umass-hrsl/ThermoClock/Acrylic tray design(STL).STL

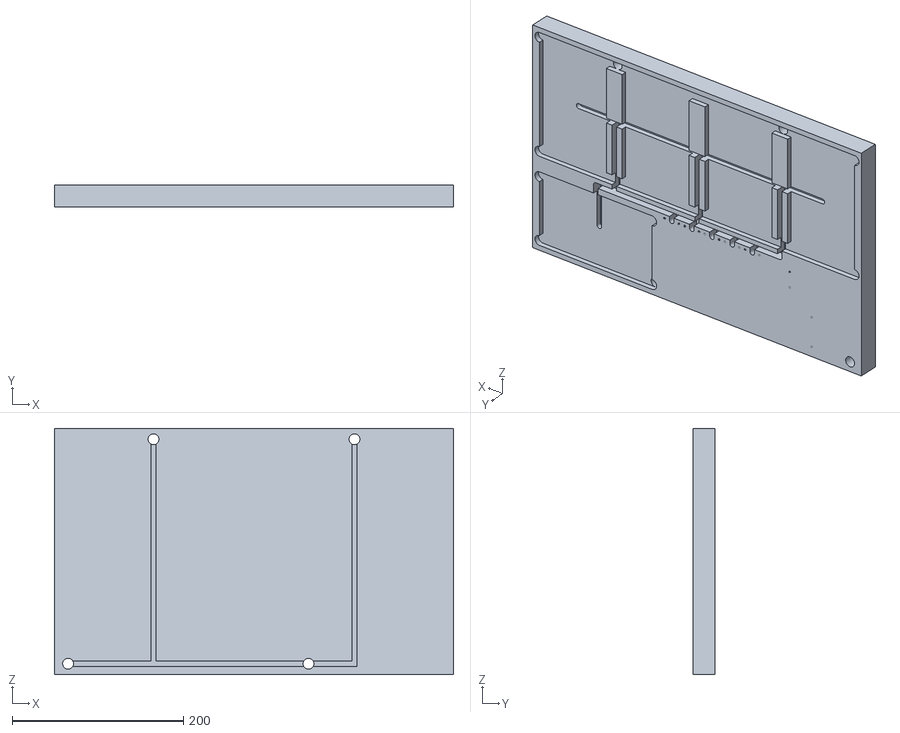
[picture p1: CAD file, 2025-08-20]
Acrylic tray design(STL).STL
466.5 x 25.4 x 287.7
