umass-hrsl/ThermoClock/alternative single module fixture CAD/6 well plate holder v3.SLDPRT

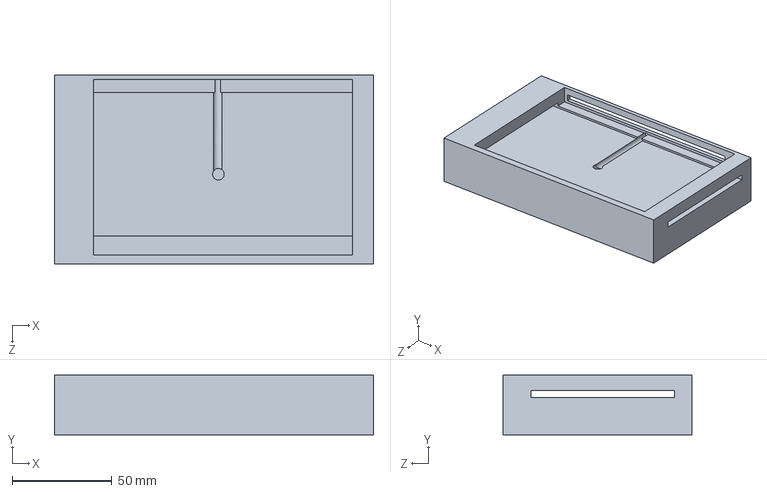
[picture p2: CAD file, 2024-07-17]
alternative single module fixture CAD/6 well plate holder v3.SLDPRT
160.0 x 30.0 x 95.0 mm
