umass-hrsl/ThermoClock/(list of files, cad)

Other CAD files:
alternative single module fixture CAD/6 well plate holder v3.STL
