umass-hrsl/ThermoClock/PCB Design/ThermoClock PCB.kicad_pcb

## KiCad design PCB Design/ThermoClock PCB.kicad_pcb (2025-02-21)

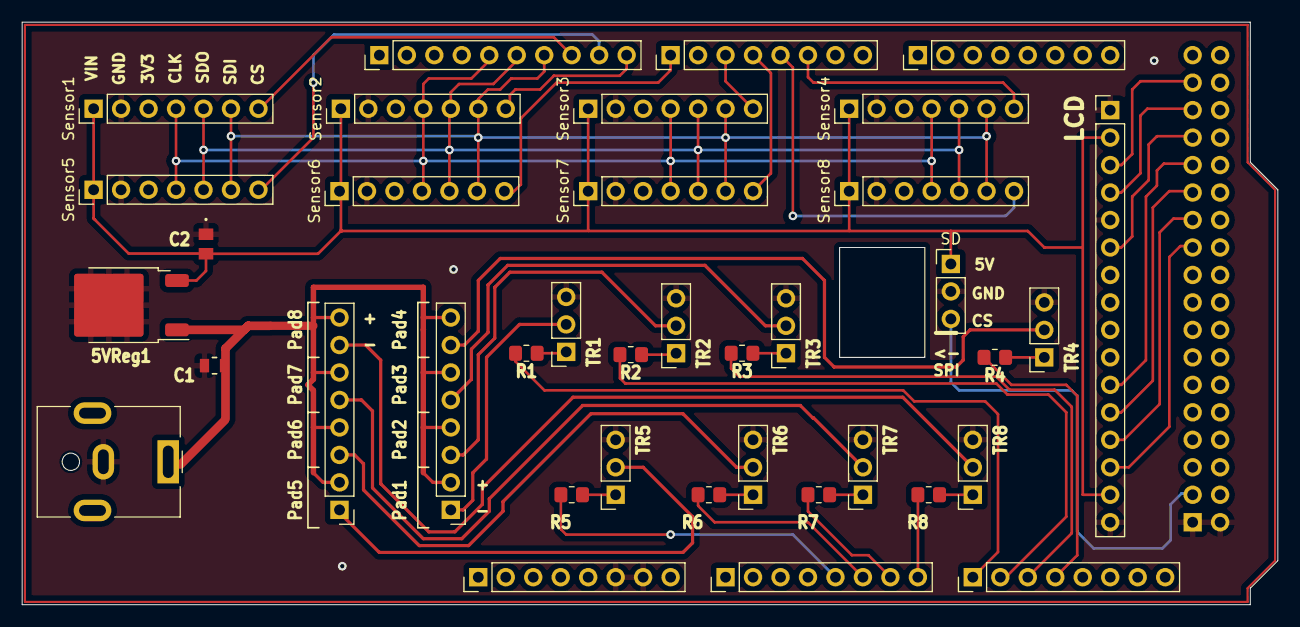
[picture p3: board ThermoClock PCB.kicad_pcb from above]

Board: 2 copper layers, 116.1 x 53.8 mm, 39 parts (1 on the bottom side), 47 nets.

Parts:
5VReg1: LM78M05_TO252; TO-252-2
C1: C; CAP_CL21_SAM
C2: C; CAP_0805_B_WAL
J1: Jack-DC; BarrelJack_CUI_PJ-063AH_Horizontal
LED1: Conn_01x16_Male; PinHeader_1x16_P2.54mm_Vertical
P1: Power; PinHeader_1x08_P2.54mm_Vertical
P2, P3: Analog; PinHeader_1x08_P2.54mm_Vertical
P4: Digital; PinHeader_2x18_P2.54mm_Vertical
P5: PWM; PinHeader_1x10_P2.54mm_Vertical
P6: PWM; PinHeader_1x08_P2.54mm_Vertical
P7: Communication; PinHeader_1x08_P2.54mm_Vertical
PAD1-1, PAD5-1: Conn_01x08_Male; PinHeader_1x08_P2.54mm_Vertical
R1, R2, R3, R4, R5, R6, R7, R8: R; R_0805_2012Metric_Pad1.20x1.40mm_HandSolder
SD: Conn_01x03; PinHeader_1x03_P2.54mm_Vertical
Sensor1, Sensor2, Sensor3, Sensor4, Sensor5, Sensor6, Sensor7, Sensor8: Conn_01x07; PinHeader_1x07_P2.54mm_Vertical
TR1, TR2, TR3, TR4, TR5, TR6, TR7, TR8: Conn_01x03; PinSocket_1x03_P2.54mm_Vertical

Connections:
+5V: P1.5, P4.35, P4.36
+12V: 5VReg1.1 (VI), C1.2, J1.1, PAD1-1.2, PAD1-1.4, PAD1-1.6, PAD1-1.8, PAD5-1.2, PAD5-1.4, PAD5-1.6, PAD5-1.8
/2(**): P6.6, Sensor4.7
/3(**): P6.5, Sensor8.7
/4(**): P6.4, Sensor7.7
/5(**): P6.3, Sensor3.7
/7(**): P6.1, Sensor6.7
/8(**): P5.10, Sensor2.7
/9(**): P5.9, Sensor5.7
/10(**): P5.8, Sensor1.7
/11(**): P5.7, Sensor1.6, Sensor2.6, Sensor3.6, Sensor4.6, Sensor5.6, Sensor6.6, Sensor7.6, Sensor8.6
/12(**): P5.6, Sensor1.5, Sensor2.5, Sensor3.5, Sensor4.5, Sensor5.5, Sensor6.5, Sensor7.5, Sensor8.5
/13(**): P5.5, Sensor1.4, Sensor2.4, Sensor3.4, Sensor4.4, Sensor5.4, Sensor6.4, Sensor7.4, Sensor8.4
/22: LED1.3, P4.33
/24: LED1.4, P4.31
/26: LED1.6, P4.29
/28: LED1.11, P4.27
/30: LED1.12, P4.25
/32: LED1.13, P4.23
/34: LED1.14, P4.21
/52(CS): P4.3, SD.3
/A4: P2.5, R5.2
/A5: P2.6, R6.2
/A6: P2.7, R7.2
/A7: P2.8, R8.2
/A8: P3.1, R1.2
/A9: P3.2, R2.2
/A10: P3.3, R3.2
/A11: P3.4, R4.2
/Pad1: PAD1-1.1, TR1.2
/Pad2: PAD1-1.3, TR2.2
/Pad3: PAD1-1.5, TR3.2
/Pad4: PAD1-1.7, TR4.2
/Pad5: PAD5-1.1, TR5.2
/Pad6: PAD5-1.3, TR6.2
/Pad7: PAD5-1.5, TR7.2
/Pad8: PAD5-1.7, TR8.2
/VCC5: 5VReg1.3 (VO), C2.2, LED1.2, LED1.15, SD.1, Sensor1.1, Sensor2.1, Sensor3.1, Sensor4.1, Sensor5.1, Sensor6.1, Sensor7.1, Sensor8.1
GND: 5VReg1.2 (GND), C1.1, C2.1, J1.2, LED1.1, LED1.5, LED1.16, P1.6, P1.7, P4.1, P4.2, P5.4, SD.2, Sensor1.2, Sensor2.2, Sensor3.2, Sensor4.2, Sensor5.2, Sensor6.2, Sensor7.2, Sensor8.2, TR1.3, TR2.3, TR3.3, TR4.3, TR5.3, TR6.3, TR7.3, TR8.3
unnamed: R1.1, TR1.1
unnamed: R2.1, TR2.1
unnamed: R3.1, TR3.1
unnamed: R4.1, TR4.1
unnamed: R5.1, TR5.1
unnamed: R6.1, TR6.1
unnamed: R7.1, TR7.1
unnamed: R8.1, TR8.1
