umass-hrsl/ThermoClock/(commit log)

2021-05-24 First Code Commit - converting Arduino (C/C++) to python
    First commit of converting Arduino (C/C++) to python for Raspberry Pi. Needs continued work to finish sensor pins and testing for temperature pid controller.
2022-10-02 code for more complete system w/ scheduling, temperature control etc and for arduino
2023-02-20 warming tray version 2 uploaded
    under development -- file initialization
    [warmingTray_v2.kicad_pcb]
2023-02-22 PCB update
    [warmingTray_v2.kicad_pcb, warmingTray_v2.kicad_sch]
2023-02-22 PID Controller creation& tuning
2023-02-22 PCB Update: added transistors and pinouts
    [warmingTray_v2.kicad_pcb, warmingTray_v2.kicad_sch]
2023-02-23 Added some libraries to project for potential use
    Digikey footprints for some parts (general one plus a transistor)
    [familylist_refdes.csv, warmingTray_v2.kicad_pcb]
2023-02-24 small changes
    [warmingTray_v2.kicad_pcb]
2023-02-24 library added
    [familylist_refdes.csv, warmingTray_v2.kicad_pcb]
2023-02-24 Added footprints for transistor pins and surface mount resistors
2023-02-28 added traces to pcb
    [warmingTray_v2.kicad_pcb, warmingTray_v2.kicad_sch]
2023-03-01 updated resistor footprint
    [warmingTray_v2.kicad_pcb]
2023-03-07 PCB & Code
    PCB: added 0805 footprints for resistors and capacitors
    Code: testing controllers again so gains are being changed
    [warmingTray_v2-B_Cu.gbr, warmingTray_v2-B_Mask.gbr, warmingTray_v2-B_Paste.gbr, warmingTray_v2-B_Silkscreen.gbr, warmingTray_v2-Edge_Cuts.gbr, warmingTray_v2-F_Cu.gbr, warmingTray_v2-F_Mask.gbr, warmingTray_v2-F_Paste.gbr]
2023-03-22 Lots of controller changes
    [warmingTray_v2-B_Cu.gbr, warmingTray_v2-B_Mask.gbr, warmingTray_v2-B_Paste.gbr, warmingTray_v2-B_Silkscreen.gbr, warmingTray_v2-Edge_Cuts.gbr, warmingTray_v2-F_Cu.gbr, warmingTray_v2-F_Mask.gbr, warmingTray_v2-F_Paste.gbr]
2023-04-19 Added PID Testing files
    Excel Sheets and Pictures for all trials thus far
    [10-0-0.csv, 100-0-0.csv, 120-0-0.csv, 140-0-0.csv, 160-0-0.csv, 170-1-25.csv, 170-1-33.csv, 170-1_1-32.csv]
2023-04-19 Test code for multiple RTD sensors
2023-07-17 Large Update of all files
    [warmingTray_v2.kicad_pcb]
2024-07-17 Prep for Final Version
    [10-0-0.csv, 100-0-0.csv, 120-0-0.csv, 140-0-0.csv, 160-0-0.csv, 170-1-25.csv, 170-1-33.csv, 170-1_1-32.csv]
2025-02-21 Update 02212025
    [6 well plate holder v3.SLDPRT, 6 well plate holder v3.STL, Bioclockbot_onepad schematics.kicad_sch, ThermoClock PCB.kicad_pcb, ThermoClock PCB.kicad_sch, warmingTray_v4.kicad_pcb, warmingTray_v4.kicad_sch]
2025-07-21 sensor pin correction
    [ThermoClock PCB.kicad_sch]
2025-08-18 RTD sensor 3 pin correction
    [ThermoClock_Arduino_Script.ino]
2025-08-20 Create Acrylic tray design(STL).STL
    [Acrylic tray design(STL).STL]
